toomanyid/GreenHouseItems/hardware/schematic/제어기_부품배치도.png

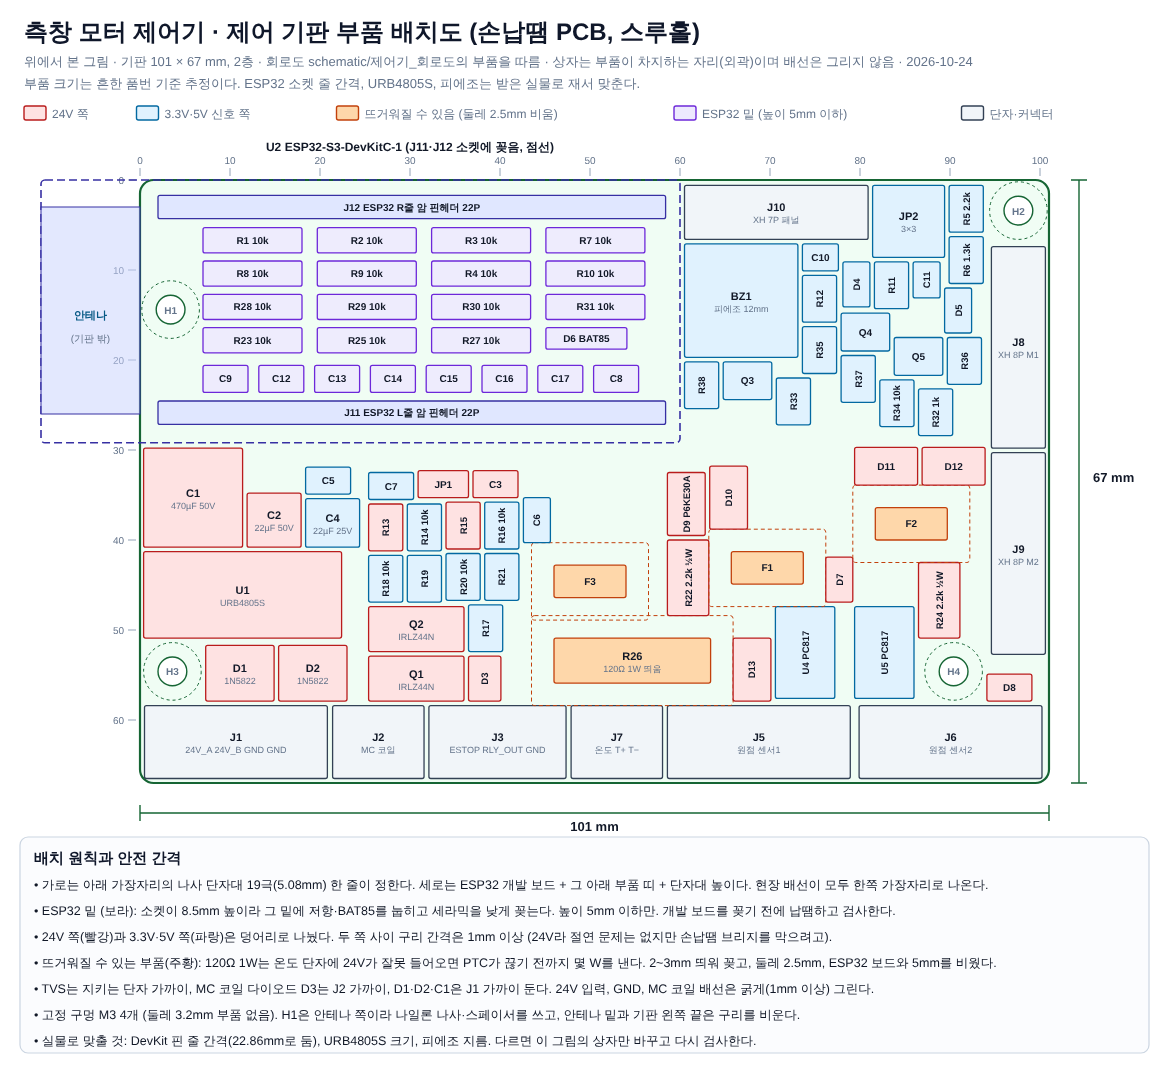
hardware/schematic/제어기_부품배치도.png
