toomanyid/GreenHouseItems/hardware/schematic/제어기_회로도.png

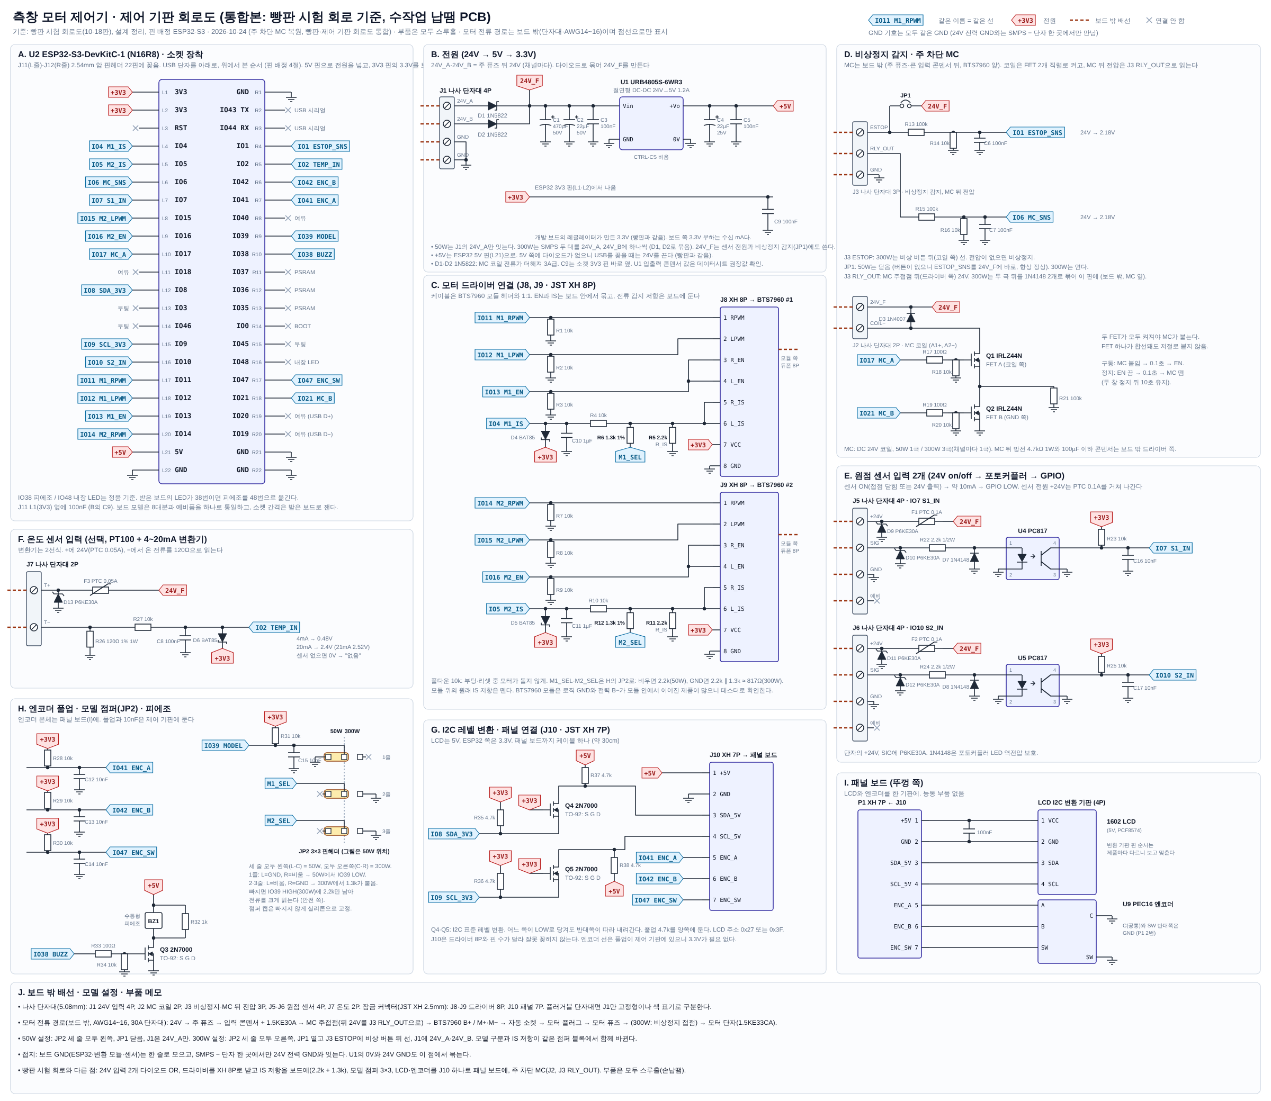
hardware/schematic/제어기_회로도.png
