toomanyid/GreenHouseItems/hardware/schematic/artwork_draft/controller.kicad_pcb

## KiCad design hardware/schematic/artwork_draft/controller.kicad_pcb (2026-10-28)

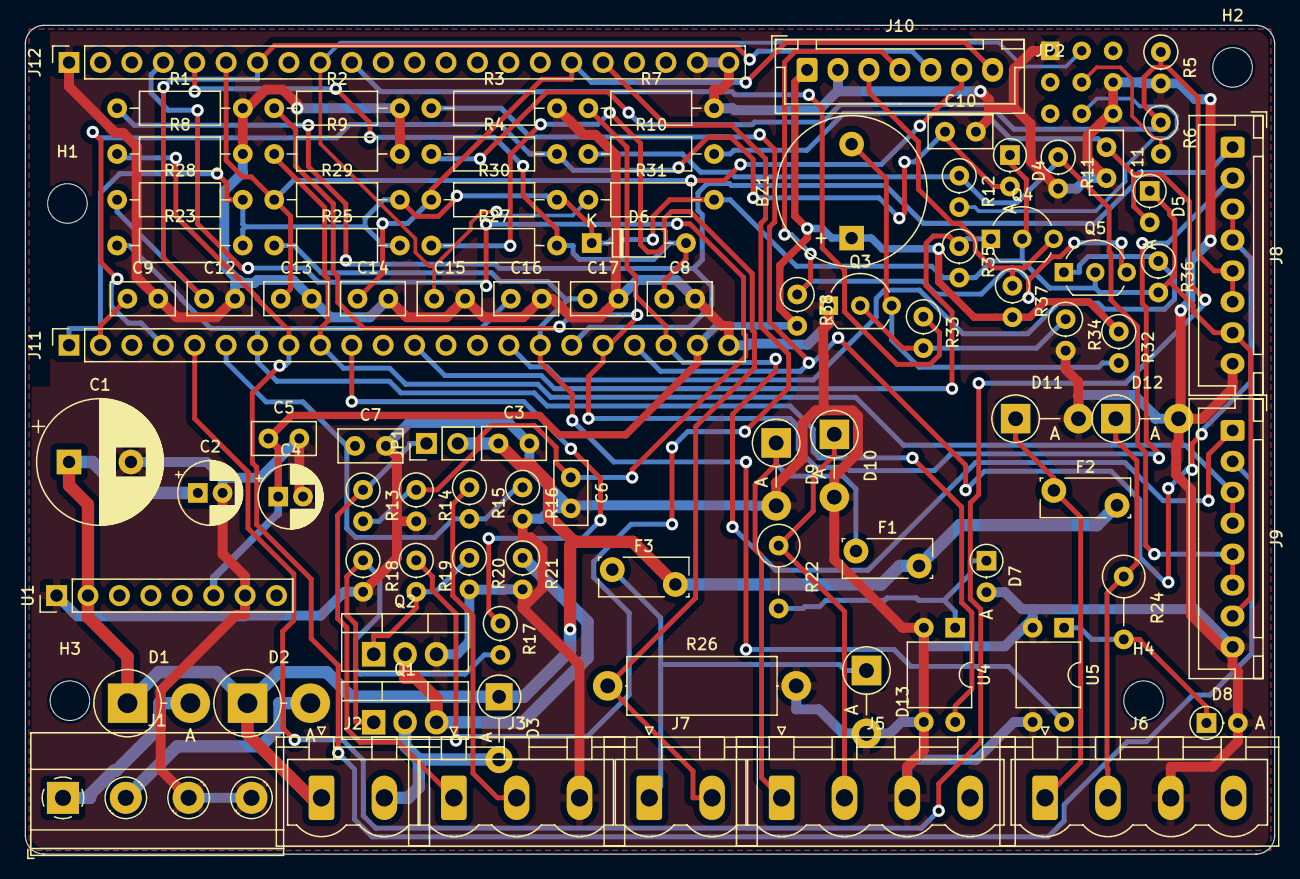
[picture p7: board controller.kicad_pcb from above]

Board: 2 copper layers, 101.0 x 67.0 mm, 97 parts (0 on the bottom side), 50 nets.

Parts:
BZ1: Buzzer_12x9.5RM7; Buzzer_12x9.5RM7.6
C1: 470uF; CP_Radial_D10.0mm_P5.00mm
C2, C4: 22uF; CP_Radial_D5.0mm_P2.00mm
C3, C5, C6, C7, C8, C9: 100nF; C_Disc_D5.0mm_W2.5mm_P2.50mm
C10, C11: 1uF; C_Disc_D5.0mm_W2.5mm_P2.50mm
C12, C13, C14, C15, C16, C17: 10nF; C_Disc_D5.0mm_W2.5mm_P2.50mm
D1, D2: 1N5822; D_DO-201AD_P5.08mm_Vertical_AnodeUp
D3: 1N4007; D_DO-41_SOD81_P5.08mm_Vertical_AnodeUp
D4, D5: BAT85; D_DO-35_SOD27_P2.54mm_Vertical_AnodeUp
D6: BAT85; D_DO-35_SOD27_P7.62mm_Horizontal
D7, D8: 1N4148; D_DO-35_SOD27_P2.54mm_Vertical_AnodeUp
D9, D10, D11, D12, D13: P6KE30A; D_DO-15_P5.08mm_Vertical_AnodeUp
F1, F2, F3: PTC; Fuse_Bourns_MF-RG300
H1, H2, H3, H4: MountingHole_3.2; MountingHole_3.2mm_M3
J1: 24V_A; TerminalBlock_Phoenix_MKDS-1,5-4-5.08_1x04_P5.08mm_Horizont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
J2: MC; PhoenixContact_MSTBVA_2,5_2-G-5,08_1x02_P5.08mm_Vertical
J3: ESTOP; PhoenixContact_MSTBVA_2,5_3-G-5,08_1x03_P5.08mm_Vertical
J5, J6: PhoenixContact_M; PhoenixContact_MSTBVA_2,5_4-G-5,08_1x04_P5.08mm_Vertical
J7: PhoenixContact_M; PhoenixContact_MSTBVA_2,5_2-G-5,08_1x02_P5.08mm_Vertical
J8, J9: XH; JST_XH_B8B-XH-A_1x08_P2.50mm_Vertical
J10: XH; JST_XH_B7B-XH-A_1x07_P2.50mm_Vertical
J11, J12: ESP32; PinSocket_1x22_P2.54mm_Vertical
JP1: 50W; PinHeader_1x02_P2.54mm_Vertical
JP2: PinHeader_3x03_P; PinHeader_3x03_P2.54mm
Q1, Q2: IRLZ44N; TO-220-3_Vertical
Q3, Q4, Q5: 2N7000; TO-92_Inline_Wide
R1, R2, R3, R4, R7, R8, R9, R10, R23, R25, R27, R28, R29, R30, R31: 10k; R_Axial_DIN0207_L6.3mm_D2.5mm_P10.16mm_Horizontal
R5, R11: 2.2k; R_Axial_DIN0207_L6.3mm_D2.5mm_P2.54mm_Vertical
R6, R12: 1.3k; R_Axial_DIN0207_L6.3mm_D2.5mm_P2.54mm_Vertical
R13, R15, R21: 100k; R_Axial_DIN0207_L6.3mm_D2.5mm_P2.54mm_Vertical
R14, R16, R18, R20, R34: 10k; R_Axial_DIN0207_L6.3mm_D2.5mm_P2.54mm_Vertical
R17, R19, R33: 100R; R_Axial_DIN0207_L6.3mm_D2.5mm_P2.54mm_Vertical
R22, R24: 2.2k; R_Axial_DIN0309_L9.0mm_D3.2mm_P5.08mm_Vertical
R26: 120R; R_Axial_DIN0414_L11.9mm_D4.5mm_P15.24mm_Horizontal
R32: 1k; R_Axial_DIN0207_L6.3mm_D2.5mm_P2.54mm_Vertical
R35, R36, R37, R38: 4.7k; R_Axial_DIN0207_L6.3mm_D2.5mm_P2.54mm_Vertical
U1: URB4805S; PinHeader_1x08_P2.54mm_Vertical
U4, U5: PC817; DIP-4_W7.62mm

Connections:
24V_A: D1.2, J1.1
24V_B: D2.2, J1.2
24V_F: C1.1, C2.1, C3.1, D1.1, D2.1, D3.1, F1.2, F2.2, F3.2, J2.1, JP1.2, U1.2
+3V3: C9.1, D4.1, D5.1, D6.1, J8.7, J9.7, J11.1, J11.2, Q4.2, Q5.2, R23.2, R25.2, R28.2, R29.2, R30.2, R31.2, R35.2, R36.2
+5V: BZ1.1, C4.1, C5.1, J10.1, J11.21, R32.1, R37.2, R38.2, U1.6
BZ_D: BZ1.2, Q3.3, R32.2
COIL-: D3.2, J2.2, Q1.2
ESTOP_IN: J3.1, JP1.1, R13.1
GND: C1.2, C2.2, C3.2, C4.2, C5.2, C6.2, C7.2, C8.2, C9.2, C10.2, C11.2, C12.2, C13.2, C14.2, C15.2, C16.2, C17.2, D7.2, D8.2, D9.2, D10.2, D11.2, D12.2, D13.2, J1.3, J1.4, J3.3, J5.3, J6.3, J8.8, J9.8, J10.2, J11.22, J12.1, J12.21, J12.22, JP2.1, JP2.6, JP2.9, Q2.3, Q3.1, R1.2, R2.2, R3.2, R5.2, R7.2, R8.2, R9.2, R11.2, R14.2, R16.2, R18.2, R20.2, R21.2, R26.2, R34.2, U1.1, U1.7, U4.2, U4.3, U5.2, U5.3
IO1: C6.1, J12.4, R13.2, R14.1
IO2: C8.1, D6.2, J12.5, R27.2
IO4: C10.1, D4.2, J11.4, R4.2
IO5: C11.1, D5.2, J11.5, R10.2
IO6: C7.1, J11.6, R15.2, R16.1
IO7: C16.1, J11.7, R23.1, U4.4
IO8: J11.12, Q4.1, R35.1
IO9: J11.15, Q5.1, R36.1
IO10: C17.1, J11.16, R25.1, U5.4
IO11: J8.1, J11.17, R1.1
IO12: J8.2, J11.18, R2.1
IO13: J8.3, J8.4, J11.19, R3.1
IO14: J9.1, J11.20, R7.1
IO15: J9.2, J11.8, R8.1
IO16: J9.3, J9.4, J11.9, R9.1
IO17: J11.10, R17.1
IO21: J12.18, R19.1
IO38: J12.10, R33.1
IO39: C15.1, J12.9, JP2.2, R31.1
IO41: C12.1, J10.5, J12.7, R28.1
IO42: C13.1, J10.6, J12.6, R29.1
IO47: C14.1, J10.7, J12.17, R30.1
M1_ISN: J8.5, J8.6, R4.1, R5.1, R6.1
M1_SEL: JP2.5, R6.2
M2_ISN: J9.5, J9.6, R10.1, R11.1, R12.1
M2_SEL: JP2.8, R12.2
Q1_G: Q1.1, R17.2, R18.1
Q2_G: Q2.1, R19.2, R20.1
Q3_G: Q3.2, R33.2, R34.1
Q_MID: Q1.3, Q2.2, R21.1
RLY_OUT: J3.2, R15.1
S1_LED: D7.1, R22.2, U4.1
S1_P24: D9.1, F1.1, J5.1
S1_SIG: D10.1, J5.2, R22.1
S2_LED: D8.1, R24.2, U5.1
S2_P24: D11.1, F2.1, J6.1
S2_SIG: D12.1, J6.2, R24.1
SCL_5V: J10.4, Q5.3, R38.1
SDA_5V: J10.3, Q4.3, R37.1
T_M: J7.2, R26.1, R27.1
T_P: D13.1, F3.1, J7.1
