toomanyid/GreenHouseItems/hardware/schematic/src/bom.py

# 아트웍용 BOM: 기호는 회로도·부품 배치도와 같다. 배치도의 부품 목록과 맞는지 검사한다.
import json
R = lambda a, b: [f'R{i}' for i in range(a, b+1)]
BOM = [
 # (기호들, 값, 규격·품번, 풋프린트, 비고)
 (['R1','R2','R3','R4','R7','R8','R9','R10','R23','R25','R27','R28','R29','R30','R31'], '10kΩ', '1/4W 금속피막 1%', '축형 눕힘, 피치 10.16 mm, 구멍 0.8 mm', 'ESP32 밑 (높이 5 mm 이하)'),
 (['R14','R16','R18','R20','R34'], '10kΩ', '1/4W 금속피막 1%', '축형 세움, 피치 2.54 mm, 구멍 0.8 mm', ''),
 (['R13','R15','R21'], '100kΩ', '1/4W 금속피막 1%', '축형 세움, 피치 2.54 mm, 구멍 0.8 mm', ''),
 (['R17','R19','R33'], '100Ω', '1/4W 금속피막 1%', '축형 세움, 피치 2.54 mm, 구멍 0.8 mm', ''),
 (['R35','R36','R37','R38'], '4.7kΩ', '1/4W 금속피막 1%', '축형 세움, 피치 2.54 mm, 구멍 0.8 mm', 'I2C 풀업 (R35·R36 3.3V, R37·R38 5V)'),
 (['R32'], '1kΩ', '1/4W 금속피막 1%', '축형 세움, 피치 2.54 mm, 구멍 0.8 mm', ''),
 (['R5','R11'], '2.2kΩ', '1/4W 금속피막 1%', '축형 세움, 피치 2.54 mm, 구멍 0.8 mm', '전류 감지'),
 (['R6','R12'], '1.3kΩ', '1/4W 금속피막 1%', '축형 세움, 피치 2.54 mm, 구멍 0.8 mm', '전류 감지 (JP2로 연결)'),
 (['R22','R24'], '2.2kΩ', '1/2W', '축형 세움, 피치 5.08 mm, 구멍 0.9 mm', '24V 쪽'),
 (['R26'], '120Ω', '1W 금속피막 1%', '축형 눕힘, 피치 15.24 mm, 구멍 1.0 mm', '발열: 2~3 mm 띄워 납땜, 둘레 2.5 mm 비움'),
 (['C1'], '470µF', '전해 50V 105℃, 지름 10 mm', '방사형, 피치 5.0 mm, 구멍 1.0 mm', '극성 표시'),
 (['C2'], '22µF', '전해 50V 105℃, 지름 5 mm', '방사형, 피치 2.0 mm, 구멍 0.8 mm', '극성 표시'),
 (['C4'], '22µF', '전해 25V 105℃, 지름 5 mm', '방사형, 피치 2.0 mm, 구멍 0.8 mm', '극성 표시'),
 (['C3','C5','C6','C7'], '100nF', '세라믹 50V', '리드형, 피치 2.54/5.08 mm 겸용, 구멍 0.8 mm', ''),
 (['C8','C9'], '100nF', '세라믹 50V', '리드형, 피치 2.54 mm, 구멍 0.8 mm', 'ESP32 밑, C9는 J11 L1(3V3) 옆'),
 (['C12','C13','C14','C15','C16','C17'], '10nF', '세라믹 50V', '리드형, 피치 2.54 mm, 구멍 0.8 mm', 'ESP32 밑'),
 (['C10','C11'], '1µF', '적층 세라믹 50V', '리드형, 피치 2.54 mm, 구멍 0.8 mm', ''),
 (['D1','D2'], '1N5822', '쇼트키 40V 3A, DO-201AD', '세움, 피치 5.08 mm, 구멍 1.3 mm', '굵은 배선 (3A)'),
 (['D3'], '1N4007', 'DO-41', '세움, 피치 5.08 mm, 구멍 1.0 mm', 'J2 가까이'),
 (['D7','D8'], '1N4148', 'DO-35', '세움, 피치 2.54 mm, 구멍 0.8 mm', ''),
 (['D4','D5'], 'BAT85', '쇼트키, DO-35', '세움, 피치 2.54 mm, 구멍 0.8 mm', ''),
 (['D6'], 'BAT85', '쇼트키, DO-35', '눕힘, 피치 7.62 mm, 구멍 0.8 mm', 'ESP32 밑'),
 (['D9','D10','D11','D12','D13'], 'P6KE30A', '단방향 TVS 600W, DO-15', '세움, 피치 5.08 mm, 구멍 1.0 mm', '지키는 단자 가까이'),
 (['F1','F2'], 'PTC 0.1A', '리셋 퓨즈 60V (예: 60R010)', '방사형, 피치 5.08 mm, 구멍 0.8 mm', '발열: 둘레 2.5 mm 비움'),
 (['F3'], 'PTC 0.05A', '리셋 퓨즈 60V (예: 60R005)', '방사형, 피치 5.08 mm, 구멍 0.8 mm', '발열: 둘레 2.5 mm 비움'),
 (['Q1','Q2'], 'IRLZ44N', 'N채널 로직 레벨 MOSFET, TO-220', '세움, 피치 2.54 mm, 구멍 1.2 mm (G D S)', ''),
 (['Q3','Q4','Q5'], '2N7000', 'N채널 MOSFET, TO-92', '일렬, 피치 2.54 mm, 구멍 0.8 mm (S G D)', 'Q3 피에조, Q4·Q5 I2C 레벨 변환'),
 (['U4','U5'], 'PC817', '포토커플러, DIP-4', 'DIP-4 7.62 mm, 구멍 0.8 mm', ''),
 (['U1'], 'URB4805S-6WR3', '절연 DC-DC 24V→5V', 'SIP, 데이터시트 핀 배치 따름', '세워 꽂음'),
 (['BZ1'], '수동 피에조', '지름 12 mm', '피치 7.6 mm, 구멍 0.8 mm (실물 확인)', '극성 표시'),
 (['J1'], '나사 단자대 4P', '5.08 mm 고정형', '피치 5.08 mm, 구멍 1.3 mm', '24V_A, 24V_B, GND, GND'),
 (['J5','J6'], '플러거블 단자대 4P', '5.08 mm 헤더 + 플러그', '피치 5.08 mm, 구멍 1.3 mm', '+24V, SIG, GND, 예비'),
 (['J3'], '플러거블 단자대 3P', '5.08 mm 헤더 + 플러그', '피치 5.08 mm, 구멍 1.3 mm', 'ESTOP, RLY_OUT, GND'),
 (['J2','J7'], '플러거블 단자대 2P', '5.08 mm 헤더 + 플러그', '피치 5.08 mm, 구멍 1.3 mm', 'J2 MC 코일, J7 온도'),
 (['J8','J9'], 'JST XH 8P', 'B8B-XH-A (세움)', '피치 2.5 mm, 구멍 1.0 mm', '실크 M1, M2'),
 (['J10'], 'JST XH 7P', 'B7B-XH-A (세움)', '피치 2.5 mm, 구멍 1.0 mm', '패널 보드'),
 (['J11','J12'], '암 핀헤더 1×22', '2.54 mm, 높이 8.5 mm', '피치 2.54 mm, 구멍 1.0 mm, 줄 간격 22.86 mm (실물 확인)', 'U2 ESP32 소켓'),
 (['JP2'], '수 핀헤더 3×3', '2.54 mm + 점퍼 캡 3', '피치 2.54 mm, 구멍 1.0 mm', '실크 50W | 300W'),
 (['JP1'], '수 핀헤더 1×2', '2.54 mm + 점퍼 캡 1', '피치 2.54 mm, 구멍 1.0 mm', '실크 50W 닫음'),
]
def refkey(r):
    import re; m = re.match(r'([A-Z]+)(\d+)', r); return (m.group(1), int(m.group(2)))
if __name__ == '__main__':
    import sys
    s = open('pcb_layout.py', encoding='utf-8').read(); g = {}
    exec(s[:s.index('errs = []')], g)
    lay = sorted(q[0] for q in g['P'])
    bom = sorted(r for b in BOM for r in b[0])
    assert len(bom) == len(set(bom)), 'BOM 기호 중복'
    miss = set(lay) ^ set(bom)
    print('배치도', len(lay), 'BOM', len(bom), '차이', sorted(miss) or '없음')
