toomanyid/GreenHouseItems/MotorController/AppStateIdle.cpp

#include "AppStateIdle.h"
#include "AppState.h"
#include <stdio.h>
#include <string.h>
#include "AppStateSetup.h"
#include "AppStateRun.h"
#include "MotorDriver.h"
#include "MotorPositionConfig.h"
#include "RotaryEncoder.h"
#include <Adafruit_GFX.h>
#include <Adafruit_SH110X.h>

// 외부 참조 (MotorController.ino에서 정의)
extern Adafruit_SH1106G display;
extern RotaryEncoder encoder;
extern MotorDriver& motor;
extern AppStateContext appStateContext;
extern int lastEncoderValue;

AppStateIdle& AppStateIdle::getInstance() {
  static AppStateIdle instance;
  return instance;
}

#define IDLE_RUN_DELAY_MS 2000   // 2초 대기 후 Run 전환
#define IDLE_ENCODER_STEP_SEC 1.0f  // 엔코더 1틱당 1초 증감

void AppStateIdle::onEnter() {
  motor.stop();
  lastEncoderValue = encoder.getValue();
  lastEncoderChangeMs = millis();
  display.setTextSize(1);
  display.setTextColor(SH110X_WHITE);
}

void AppStateIdle::onKey(Key key) {
  MotorPositionConfig& config = MotorPositionConfigManager::getInstance();
  float minSec = config.getMinSec();
  float topSec = config.getTopSec();
  float targetSec = config.getTargetSec();
  float positions[] = {config.getMinSec(), config.getBottomSec(), config.getTopSec(), config.getMaxSec()};
  unsigned long now = millis();

  if (key == Key::Push) {
    appStateContext.setState(&AppStateSetup::getInstance());
    return;
  }
  if (key == Key::Cw) {
    float next = config.getMaxSec() + 1;
    for (int i = 0; i < 4; i++) {
      if (positions[i] > targetSec && positions[i] < next) next = positions[i];
    }
    if (next <= topSec) {
      config.setTargetSec(next);
      lastEncoderChangeMs = now;
    }
    return;
  }
  if (key == Key::Ccw) {
    float next = -1;
    for (int i = 0; i < 4; i++) {
      if (positions[i] < targetSec && positions[i] > next) next = positions[i];
    }
    if (next >= minSec) {
      config.setTargetSec(next);
      lastEncoderChangeMs = now;
    }
  }
}

void AppStateIdle::onUpdate() {
  int currentValue = encoder.getValue();
  unsigned long now = millis();
  
  // 로터리 회전: 1초씩 증감, 2초 타이머 리셋 (목표 min~top 범위)
  MotorPositionConfig& config = MotorPositionConfigManager::getInstance();
  float minSec = config.getMinSec();
  float bottomSec = config.getBottomSec();
  float topSec = config.getTopSec();
  if (currentValue != lastEncoderValue) {
    int delta = currentValue - lastEncoderValue;
    float newTarget = config.getTargetSec() + delta * IDLE_ENCODER_STEP_SEC;
    if (newTarget < minSec) newTarget = minSec;
    if (newTarget > topSec) newTarget = topSec;
    config.setTargetSec(newTarget);
    lastEncoderValue = currentValue;
    lastEncoderChangeMs = now;
  }
  
  // 2초 대기 후 Run 전환 (목표가 현재와 다를 때만)
  float target = config.getTargetSec();
  if ((now - lastEncoderChangeMs) >= IDLE_RUN_DELAY_MS &&
      fabsf(target - motor.getPositionSec()) > 0.05f) {
    appStateContext.setState(&AppStateRun::getInstance());
    return;
  }
  
  // 화면 표시: bottom 기준 시간(초), bottom=0.0 (-0 표시 방지)
  float posSec = motor.getPositionSec();
  float displaySec = (now - lastEncoderChangeMs) < IDLE_RUN_DELAY_MS ? (config.getTargetSec() - bottomSec) : (posSec - bottomSec);
  if (displaySec > -0.05f && displaySec < 0.05f) displaySec = 0.0f;
  float leftVal = posSec - bottomSec;
  if (leftVal > -0.05f && leftVal < 0.05f) leftVal = 0.0f;
  
  display.clearDisplay();
  display.setTextColor(SH110X_WHITE);
  
  bool targetChanged = (now - lastEncoderChangeMs) < IDLE_RUN_DELAY_MS;
  if (targetChanged) {
    display.setTextSize(1);
    display.setCursor(0, 0);
    char leftBuf[16];
    snprintf(leftBuf, sizeof(leftBuf), "%.1f->", leftVal);
    display.print(leftBuf);
  }
  
  char buf[16];
  snprintf(buf, sizeof(buf), "%.1f", displaySec);
  int len = strlen(buf);
  int charW = 18;
  int totalW = len * charW;
  int x = (128 - totalW) / 2;
  display.setTextSize(3);
  display.setCursor(x, 20);
  display.print(buf);
  display.display();
}
