toomanyid/GreenHouseItems/MotorController2/motor.h

#pragma once
#include <Arduino.h>
#include "config.h"

enum class MotorDir { STOP, FORWARD, REVERSE };
enum class MotorState {
    IDLE,
    RAMPING_UP,
    RUNNING,
    RAMPING_DOWN,
    OVERCURRENT_ERROR
};

class Motor {
public:
    Motor();
    void begin();

    // 명령
    void moveTo(float target_sec, float overcurrent_a);  // 시간 기반 목표 이동
    void stop();                                          // 즉시 소프트스톱 시작
    void emergencyStop();                                 // 즉시 강제 정지

    // 루프에서 매번 호출 (current_a: 이미 읽은 전류값, overcurrent_a: 임계값)
    void update(float current_a, float overcurrent_a);

    // 상태 조회
    MotorState  getState()       const { return _state; }
    MotorDir    getDir()         const { return _dir; }
    float       getPositionSec() const { return _position_ds / 10.0f; }
    bool        isMoving()       const { return _state == MotorState::RAMPING_UP
                                              || _state == MotorState::RUNNING
                                              || _state == MotorState::RAMPING_DOWN; }
    bool        isError()        const { return _state == MotorState::OVERCURRENT_ERROR; }
    void        clearError()           { if (_state == MotorState::OVERCURRENT_ERROR) {
                                             _target_ds = _position_ds;  // 즉시 재이동 방지
                                             _pos_frac  = 0;
                                             _state     = MotorState::IDLE;
                                         } }

    // 위치 강제 설정 (자동 설정에서 사용)
    void setPosition(float sec) {
        _position_ds = (int32_t)roundf(sec * 10.0f);
        _pos_frac    = 0;
    }

private:
    MotorState  _state;
    MotorDir    _dir;

    // 위치: 0.1초(decisecond) 단위 정수 (10배수)
    // 예) 125 = 12.5초
    int32_t     _position_ds;     // 현재 위치
    int32_t     _target_ds;       // 목표 위치
    int32_t     _pos_frac;        // 서브-ds 누적 잔여분 (0~99, 100 = 1 ds)

    uint32_t    _ramp_start_ms;
    uint32_t    _last_update_ms;

    float       _current_duty;    // 0.0 ~ 1.0

    void        setDuty(MotorDir dir, float duty);
    void        setPWM(uint8_t pin_a, uint8_t pin_b, float duty_a, float duty_b);
    bool        checkOvercurrent(float current_a, float threshold_a);
};

extern Motor motor;
