toomanyid/GreenHouseItems/MotorController/AppStateRun.cpp

#include "AppStateRun.h"
#include "AppState.h"
#include "AppStateIdle.h"
#include "AppStateFault.h"
#include "MotorDriver.h"
#include "MotorPositionConfig.h"
#include "CurrentSensor.h"
#include "RotaryEncoder.h"
#include <Adafruit_GFX.h>
#include <Adafruit_SH110X.h>
#include <stdio.h>
#include <string.h>

extern Adafruit_SH1106G display;
extern RotaryEncoder encoder;
extern MotorDriver& motor;
extern CurrentSensor& currentSensor;
extern AppStateContext appStateContext;

AppStateRun& AppStateRun::getInstance() {
  static AppStateRun instance;
  return instance;
}

AppStateRun::AppStateRun()
  : targetPositionSec(0), lastEncoderValue(0) {
}

void AppStateRun::onEnter() {
  targetPositionSec = MotorPositionConfigManager::getInstance().getTargetSec();
  lastEncoderValue = encoder.getValue();
  display.setTextSize(1);
  display.setTextColor(SH110X_WHITE);
}

void AppStateRun::onKey(Key key) {
  // PUSH / CW / CCW: 취소 → Idle
  motor.stop();
  appStateContext.setState(&AppStateIdle::getInstance());
}

void AppStateRun::onUpdate() {
  unsigned long now = millis();
  float posSec = motor.getPositionSec();
  MotorPositionConfig& config = MotorPositionConfigManager::getInstance();
  float bottomSec = config.getBottomSec();
  
  // 로터리 회전: 모터 정지 → Idle로 복귀
  int encVal = encoder.getValue();
  if (encVal != lastEncoderValue) {
    motor.stop();
    appStateContext.setState(&AppStateIdle::getInstance());
    return;
  }
  
  // 전류 모니터링: maxCurrent 초과 시 Fault 전환
  float currentA = currentSensor.getCurrent();
  if (fabsf(currentA) > config.getMaxCurrent()) {
    motor.stop();
    appStateContext.setState(&AppStateFault::getInstance());
    return;
  }
  
  // 모터 구동
  {
    // 목표 도달 체크
    float diff = targetPositionSec - posSec;
    if (abs(diff) < RUN_ARRIVAL_THRESHOLD) {
      motor.stop();
      appStateContext.setState(&AppStateIdle::getInstance());
      return;
    }
    // 모터 구동 (CW/CCW)
    if (diff > 0) motor.runCW(100);
    else motor.runCCW(100);  // 내려갈 때도 올라갈 때와 동일 속도
  }
  
  // 디스플레이: bottom=0.0초 기준, -0 표시 방지
  float dispTarget = targetPositionSec - bottomSec;
  float dispCurrent = posSec - bottomSec;
  if (dispTarget > -0.05f && dispTarget < 0.05f) dispTarget = 0.0f;
  if (dispCurrent > -0.05f && dispCurrent < 0.05f) dispCurrent = 0.0f;
  
  display.clearDisplay();
  display.setTextColor(SH110X_WHITE);
  
  display.setTextSize(1);
  display.setCursor(0, 0);
  char leftBuf[16];
  snprintf(leftBuf, sizeof(leftBuf), "->%.1f", dispTarget);
  display.print(leftBuf);
  
  char buf[16];
  snprintf(buf, sizeof(buf), "%.1f", dispCurrent);
  int len = strlen(buf);
  int charW = 18;
  int totalW = len * charW;
  int x = (128 - totalW) / 2;
  display.setTextSize(3);
  display.setCursor(x, 20);
  display.print(buf);
  display.display();
}
