toomanyid/GreenHouseItems/WinCtrl/dev_OledFont.h

#pragma once
#include <stdint.h>

// OLED용 8x16 글꼴, ASCII 32~126. X11 misc-fixed 8x16(공개 도메인)에서 뽑았다.
// 글자마다 16바이트: 윗쪽 페이지 8열, 아랫쪽 페이지 8열. 각 바이트의 LSB가 위.
static const uint8_t OLED_FONT_8X16[95][16] = {
    {0x00,0x00,0x00,0x00,0x00,0x00,0x00,0x00,0x00,0x00,0x00,0x00,0x00,0x00,0x00,0x00},  // ' '
    {0x00,0x00,0x00,0x00,0xF0,0x00,0x00,0x00,0x00,0x00,0x00,0x00,0x37,0x00,0x00,0x00},  // '!'
    {0x00,0x00,0x3C,0x00,0x00,0x00,0x3C,0x00,0x00,0x00,0x00,0x00,0x00,0x00,0x00,0x00},  // '"'
    {0x00,0x80,0x80,0xF0,0x80,0x80,0xF0,0x00,0x00,0x3C,0x07,0x04,0x3C,0x07,0x04,0x00},  // '#'
    {0x00,0xC0,0x20,0x20,0xF0,0x20,0x20,0x40,0x00,0x08,0x11,0x11,0x3F,0x12,0x12,0x0C},  // '$'
    {0x00,0x60,0x90,0x90,0x60,0x80,0x60,0x10,0x00,0x20,0x18,0x04,0x1B,0x24,0x24,0x18},  // '%'
    {0x00,0x00,0xE0,0x10,0x10,0x10,0xE0,0x00,0x00,0x1C,0x22,0x23,0x23,0x15,0x18,0x26},  // '&'
    {0x00,0x00,0x00,0x00,0x3C,0x00,0x00,0x00,0x00,0x00,0x00,0x00,0x00,0x00,0x00,0x00},  // "'"
    {0x00,0x00,0x00,0xC0,0x30,0x08,0x00,0x00,0x00,0x00,0x00,0x0F,0x30,0x40,0x00,0x00},  // '('
    {0x00,0x00,0x08,0x30,0xC0,0x00,0x00,0x00,0x00,0x00,0x40,0x30,0x0F,0x00,0x00,0x00},  // ')'
    {0x00,0x80,0x00,0x00,0xC0,0x00,0x00,0x80,0x00,0x08,0x05,0x02,0x1F,0x02,0x05,0x08},  // '*'
    {0x00,0x00,0x00,0x00,0xC0,0x00,0x00,0x00,0x00,0x02,0x02,0x02,0x1F,0x02,0x02,0x02},  // '+'
    {0x00,0x00,0x00,0x00,0x00,0x00,0x00,0x00,0x00,0x00,0x00,0x90,0x70,0x00,0x00,0x00},  // ','
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
    {0x00,0xF0,0x10,0x10,0x10,0x10,0x10,0x00,0x00,0x3F,0x21,0x21,0x21,0x21,0x20,0x00},  // 'E'
    {0x00,0xF0,0x10,0x10,0x10,0x10,0x10,0x00,0x00,0x3F,0x01,0x01,0x01,0x01,0x00,0x00},  // 'F'
    {0x00,0xE0,0x10,0x10,0x10,0x10,0x60,0x00,0x00,0x1F,0x20,0x20,0x22,0x12,0x3E,0x00},  // 'G'
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
};
