toomanyid/GreenHouseItems/(commit log)

2026-02-01 싱글톤으로 수정. state 패턴 적용. 설정값 저장/로드 기능 추가
    [AppState.cpp, AppState.h, AppStateIdle.cpp, AppStateIdle.h, AppStateSetup.cpp, AppStateSetup.h, CurrentSensor.cpp, CurrentSensor.h]
2026-02-01 아직은 기본 구성중.
2026-02-01 아이들과 런을 구성하고 있는중.
2026-02-01 설정 화면 구성중.
2026-02-03 화면 표시를 시간에서 퍼센트로 변경 top이상으로 이동 할 수 없도록 수정. up, down 버튼을 누르면 다음 목표로 이동.
    [AppStateIdle.cpp, AppStateRun.cpp, AppStateSetup.cpp, MotorController.ino, MotorPositionConfig.h]
2026-02-03 설정에 최대전류값을 추가.
2026-02-03 전류 에따른 모터 정지 기능 추가.
2026-02-03 화면 표시를 퍼센트로 변경시
2026-02-10 모터 현제위치 표시 방법 변경
2026-02-21 모터 드라이버에서 과전류 콜백 직접 받음.
2026-02-21 min, zero, limit, max 로 모터 위치명 수정.
    [AppStateIdle.cpp, AppStateRun.cpp, AppStateSetup.cpp, AppStateSetup.h, MotorController.ino, MotorPositionConfig.cpp, MotorPositionConfig.h]
2026-02-21 키큐를 이용하는 방법으로 키 입력방법 수정.
    [AppState.cpp, AppState.h, AppStateFault.cpp, AppStateFault.h, AppStateIdle.cpp, AppStateIdle.h, AppStateRun.cpp, AppStateRun.h]
2026-02-21 키입력시 눌릴때만 입력으로 확인 하도록 수정.
    [ButtonInterrupt.cpp, ButtonInterrupt.h]
2026-02-25 버튼입력이 놓을때도 입력되는문제 수정.
    [ButtonInterrupt.cpp, ButtonInterrupt.h, MotorController.ino]
2026-03-06 설정을 min, bottom, top, max 로 변경.
2026-03-06 실수형에서 10배수 정수형으로 변경.
2026-03-06 전류도 10배수 정수로 관리.
2026-03-06 컴파일 문제 수정.
2026-03-06 아이들에서 로터리 회전시 1초씩 증감.
2026-04-12 PicoMotorController: nine-grid RUN OLED layout, 2s encoder arm delay
2026-04-13 PicoMotorController: 2s soft start, speed-aware position, HB current
2026-04-13 PicoMotorController: stop RUN on encoder push (debounced)
2026-05-16 Add MotorController2: Modbus RTU motor control with OLED and flash settings
2026-05-16 ssh 초기화
2026-05-21 모터 콘트롤러2 추가.
2026-10-13 측창 모터 제어기 펌웨어 0.9 (WinCtrl)
    ESP32-S3 2채널 측창 모터 제어기 펌웨어. 스펙 v0.9의 네 층 구조로
    창 상태 흐름, 안전 판정, 온도제어, 화면과 설정 메뉴, 플래시 저장을 넣었다.
    2층과 3층, 화면 글자는 PC 시험(test/run_tests.sh)으로 확인했다.
    Claude-Session: https://claude.ai/code/session_012rckpJcfA365o5geM7HYug
2026-10-13 원점 센서를 on/off 입력 하나로 바꿈
    스펙과 핀 배정 문서 변경에 맞춤. 센서1은 GPIO7, 센서2는 GPIO10, ON이면 LOW.
    18, 19번은 여유 핀. 센서 유무는 ON이 들어오면 있음, OFF인 채로 처음 하한에
    닿으면 없음으로 정하고, 단선은 위치 확인으로 잡는다. 에러 확인 시 센서 판단을
    처음으로 돌린다.
    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
2026-10-16 시리얼 부팅 로그와 I2C 검색 추가
    LCD가 안 나올 때 보드가 살아 있는지 확인할 수 있게, 부팅 시 버전·모델·
    I2C 장치 주소를 115200bps로 찍고 loop()에서 5초마다 살아 있음 표시를 낸다.
    Claude-Session: https://claude.ai/code/session_01Bxbg72ZBXr1R6WQkEDLZZp
2026-10-16 I2C 선 상태와 begin 결과를 시리얼에 찍음
    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
2026-10-16 엔코더 회전, 누름, 핀 상태를 시리얼에 찍음
    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
2026-10-16 LCD가 없으면 I2C OLED에 같은 두 줄을 띄움 (시험용)
    SSD1306/SH1106 128x64(0x3C/0x3D)를 찾으면 16x2 글자를 8x16 글꼴로 그린다.
    글꼴은 X11 misc-fixed 8x16(공개 도메인)에서 뽑았다.
    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
    [dev_Lcd.cpp, dev_Lcd.h, dev_OledFont.h]
2026-10-16 OLED: SH1106의 132열까지 지워 오른쪽 줄무늬 없앰
    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
2026-10-16 살아 있음 로그에 비상정지, 릴레이 감지 핀 전압 추가
    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
2026-10-16 엔코더 방향을 config.h의 ENC_DIRECTION으로 바꿀 수 있게 하고 반대로 맞춤
    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
2026-10-16 핀 전압 로그 뺌 (제어 태스크와 ADC를 같이 읽지 않게)
    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
2026-10-16 WinCtrl에 CLAUDE.md 추가: 기준 문서, 개발 환경, 구조 규칙, 책상 시험 메모
    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
2026-10-18 시험 스크립트가 맥(clang)에서도 돌게 함
    -Wno-format-truncation은 GCC 전용이라 맥의 g++(clang)이 -Werror로 멈췄다.
    그 앞에 -Wno-unknown-warning-option을 넣는다. GCC는 모르는 -Wno-*를 그냥 넘긴다.
2026-10-18 화면 시리얼 로그 추가: LCD 초기화 결과, 백라이트 켜짐/꺼짐과 켜 두는 이유
    - [lcd] begin/reinit: 주소, LCD/OLED, OK/FAIL, 백라이트 상태
    - [lcd] backlight ON/OFF: 바뀔 때만
    - [lcd] backlight held by: moving/fault/estop/splash, 이유가 바뀔 때만
    [io_UiTask.cpp]
2026-10-18 책상 시험 빌드(winctrl_bench) 추가: 릴레이 뒤 전압 점검 생략
    24V 없이 책상에서 시험할 때 릴레이 에러가 나지 않게 한다.
    -DWINCTRL_BENCH일 때만 RelayControl이 GPIO6 전압 대신 FET A, B가
    둘 다 켜졌을 때만 전압이 있다고 보고 정상 릴레이처럼 판정한다.
    기본 빌드(winctrl)와 아두이노 IDE 빌드는 바뀌지 않는다.
    부팅 때 시리얼에 BENCH BUILD 경고를 찍는다. 현장 설치에 쓰지 않는다.
    빌드: pio run -e winctrl_bench -t upload
    시험: run_tests.sh가 시험 모드 릴레이 판정도 돌린다.
2026-10-18 .DS_Store를 저장소에서 빼고 .gitignore에 추가
    맥 Finder가 폴더를 열 때마다 바꾸는 파일이라 추적하지 않는다.
    맥에 있는 파일은 그대로 둔다.
2026-10-24 주 차단 MC: 두 창이 멈춘 뒤 10초 더 붙여 두기
    스펙 6절(2026-10-24): 두 창이 모두 멈추면 MC를 10초 유지했다가 뗀다.
    그 안에 다음 이동이 오면 다시 붙이지 않고 바로 구동한다. 비상정지와
    고장(FAULT) 때는 유지 시간 없이 EN을 끈 0.1초 뒤에 바로 뗀다.
    Claude-Session: https://claude.ai/code/session_01KASnygYG8y1D3kyKUZkRhD
2026-10-24 회로도에 맞춤: 온도 감지 저항 120Ω, 300W 전류 감지 817Ω, 주석의 릴레이를 MC로
    - TEMP_SENSE_OHM 150 → 120 (기판 R26 120Ω 1W). 150으로 두면 온도를 낮게 읽는다
    - SENSE_OHM_300W 820 → 817 (2.2kΩ ∥ 1.3kΩ)
    - 주석과 README, CLAUDE.md의 '릴레이'를 '주 차단 MC'로. 코드 이름 relay는 그대로
    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
2026-10-28 2004 LCD 자동 선택: 백팩 주소 0x26 (A0 이음)이면 2004로 보고 지금의 두 줄을 그린다
2026-10-28 UI 시험 빌드(winctrl_ui) 추가: LCD와 엔코더만 단 보드에서 화면을 끝까지 돌린다
    1층이 실제 핀 대신 가짜 개폐기(dev_Sim.h)의 값을 돌려준다.
    모터와 릴레이 핀은 늘 끊어 두고, 비상정지와 릴레이 뒤 전압은 정상,
    전류와 원점 센서는 가짜 창 위치(30초 이동, 센서 3초)를 따르고 온도는 25.0도.
    부팅 시 시리얼과 시작 화면에 UI SIM BUILD를 띄운다.
2026-10-28 하드웨어: 회로도 원본과 결과물, 변경안 메모, 옛 회로도 추가
    프로젝트 공유 폴더에만 있던 회로도 작업을 hardware/ 아래로 옮겼다.
    - schematic/: 통합 회로도, 부품배치도, 아트웍 의뢰서, PCB·거버 초안, 파이썬 원본
    - changes/: 확인받아 반영한 회로 변경안 메모
    - old/: 통합 전 빵판, 베이스 보드 회로도
    __pycache__는 빼고 .gitignore에 넣었다.
    Claude-Session: https://claude.ai/code/session_017QM6MVSxggw4NggnPnjGCJ
    [controller.kicad_pcb]
2026-10-28 책상 시험 빌드의 가짜 릴레이 전압을 2층에서 1층(dev_Relay)으로 옮김
    UI 시험 빌드와 같은 방식으로, FET A, B가 둘 다 켜졌을 때만 24V로 본다.
    2층 안전 판정에는 빌드별 #ifdef가 남지 않으므로 2층 시험은 늘 실제 규칙으로만 돈다.
    문법 확인에 책상 시험 빌드를 더했다.
2026-10-28 화면과 조작을 스펙 7절(2026-10-24 변경)에 맞춤
    - 위치는 백분율(0.0~99.9)로만 보임. 엔코더 한 칸 0.5, 빨리 돌리면 5, 10
    - 짧게 누를 때마다 온도 → 위치 동기 → 1채널 → 2채널. 온도 항목이 자동, 위치 항목이 수동
    - 위치 동기: 두 창에 같은 증감, 낮은 쪽을 큰 글씨로, 다르면 ≠. 창 칸이 "양쪽"인 잡 하나로 두 창이 같은 주기에 출발
    - 개별 항목은 가로 두 배 숫자, 도착하거나 5초 조작이 없으면 위치 동기로
    - 큰 글씨(사용자 글자 5개 + 꽉 찬 글자), 작은 글씨 화면은 에러와 원점 찾기에만
    - 깜빡임: 고른 값 0.8/0.2초, 바꾸는 중 0.5/0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
2026-10-28 화면 글자 깜빡임을 모두 없애고 엔코더 첫 한 칸은 입력 시작으로 (스펙 7절 2026-10-28 변경)
    - 평소 화면: 입력 중이 아닐 때 첫 한 칸은 값을 바꾸지 않고 입력만 시작한다.
    그 뒤로는 한 칸마다 바뀐다. '0.5초 안에 두 칸' 규칙은 없앴다.
    - 고른 값, 바꾸는 값, 목표, 상태 글자, --.-C, E-STOP 글자는 깜빡이지 않는다.
    - 선택 표시: 개별 화면에서 고른 창은 번호 옆에 *, 메뉴에서 바꾸는 값 앞에 >,
    측정 결과 저장 확인은 고른 쪽을 [ ]로 감싼다.
    - 백라이트 경보 깜빡임은 그대로 둔다.
2026-10-28 큰 글씨를 칸 틈이 획 사이에 오는 7획 글씨로 바꿈
    세로획은 양옆 칸에 3점, 가로획은 가운데 칸에만 2줄로 그린다.
    숫자 사이 빈칸을 없애 큰 숫자가 왼쪽 10칸을 쓴다. 사용자 글자 7개,
    ROM의 꽉 찬 글자는 쓰지 않는다.
    Claude-Session: https://claude.ai/code/session_017QM6MVcCosyLVadrwRByQy
2026-10-28 큰 글씨의 소수 자리를 아랫줄 가로 두 배 숫자로 바꿈
    정수 두 자리는 가로세로 확대, 소수 자리는 가로 두 배 숫자를 한 줄
    내려 큰 숫자와 바닥을 맞춘다. 사용자 글자 0~5번은 고정 획, 6~7번은
    소수 자리 반쪽이다. 글자가 모자라 위치 동기의 '다름' 표시는 ≠ 대신
    ROM의 *로 한다.
    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
